JCCopyrights/Arriquitaun2.0/README.md

# Arriquitaun Project

Project to create a retroconsole using hardware coprocessors.

Thanks to @aquimb and specially Yago Torroja.
