JCCopyrights/Arriquitaun2.0/res/flamenco-dancer-clapping-silhouette-by-vexels.bmp

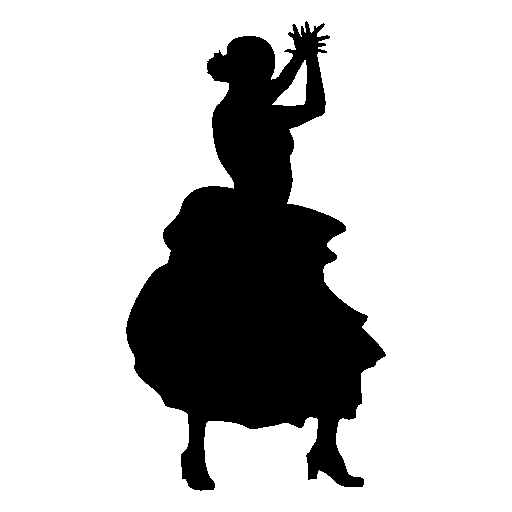
res/flamenco-dancer-clapping-silhouette-by-vexels.bmp
