JCCopyrights/Arriquitaun2.0/docs/BOM.xlsx

Part | Manufacturer Code | Needed x 1 | Neded x 3 | To Order | price 1 | price 5 | price 10 | price 25 | price 50 | price 100 | Llegado | Order [€] | Distributor | Code | link
micro | ATMEGA644PA-AU | 1 | 3 | 4 | 4.38 |  | 43.1 |  |  |  | 4 | 17.52 | Mouser | 556-ATMEGA644PA-AU | https://eu.mouser.com/ProductDetail/Microchip-Technology-Atmel/ATMEGA644PA-AU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
usb | 47346-0001 | 1 | 3 | 4 | 0.78 |  | 7.03 |  |  |  | 4 | 3.12 | Mouser | 538-47346-0001 | https://eu.mouser.com/ProductDetail/Molex/47346-0001
led | 598-8210-107F | 9 | 27 | 30 | 0.4 |  | 2.25 |  |  |  | 30 | 6.75 | Mouser | 645-598-8210-107F | https://eu.mouser.com/ProductDetail/Dialight/598-8210-107F
flash 4Mb | AT25SF041-SSHD-T | 1 | 3 | 4 | 0.31 |  | 2.6 |  |  |  | 4 | 1.24 | Mouser | 988-AT25SF041-SSHD-T | https://eu.mouser.com/ProductDetail/Adesto-Technologies/AT25SF041-SSHD-T
tactil switch | EVQ-Q2D01W | 1 | 3 | 4 | 0.26 |  | 2.4 |  |  |  | 4 | 1.04 | Mouser | 667-EVQ-Q2D01W | https://eu.mouser.com/ProductDetail/Panasonic/EVQ-Q2D01W
boton | FSM100 | 6 | 18 | 20 | 0.27 |  | 2.35 |  |  |  | 20 | 4.7 | Mouser | 506-FSM100 | https://eu.mouser.com/ProductDetail/TE-Connectivity-Alcoswitch/FSM100
ftdi | FT2232HL-TRAY | 1 | 3 | 4 | 5.86 |  | 54.1 |  |  |  | 4 | 23.44 | Mouser | 895-FT2232HL-TRAY | https://eu.mouser.com/ProductDetail/FTDI/FT2232HL-TRAY
SRAM 2Mb | IS62WVS2568FBLL-20NLI | 1 | 3 | 4 | 2.66 |  | 23.5 |  |  |  | 4 | 10.64 | Mouser | 870-WVS2568FBLL20NLI | https://eu.mouser.com/ProductDetail/ISSI/IS62WVS2568FBLL-20NLI
VGA connector | L77HDE15SD1CH4R | 1 | 3 | 4 | 1.14 |  | 10.4 |  |  |  | 4 | 4.56 | Mouser | 523-L77HDE15SD1CH4R | https://www.mouser.es/ProductDetail/Amphenol-Commercial-Products/L77HDE15SD1CH4R
fpga | ICE40UP5K-SG48I | 1 | 3 | 4 | 5.24 |  |  | 114.5 |  |  | 4 | 20.96 | Mouser | 842-ICE40UP5K-SG48I | https://eu.mouser.com/ProductDetail/Lattice/ICE40UP5K-SG48I
regu 3,3 | LD1117S33CTR | 1 | 3 | 4 | 0.35 |  | 2.95 |  |  |  | 4 | 1.4 | Mouser | 511-LD1117S33C | https://eu.mouser.com/ProductDetail/STMicroelectronics/LD1117S33CTR
eeprom 1Kb | M93C46-WMN6P | 1 | 3 | 4 | 0.14 |  | 1.21 |  |  |  | 4 | 0.56 | Mouser | 511-M93C46-WMN6P | https://eu.mouser.com/ProductDetail/STMicroelectronics/M93C46-WMN6P
regu 1.2 | TLV117112DCYR | 1 | 3 | 4 | 0.58 |  | 4.8 |  |  |  | 4 | 2.32 | Mouser | 595-TLV117112DCYR | https://eu.mouser.com/ProductDetail/Texas-Instruments/TLV117112DCYR
pal | 161-0097-E | 2 | 6 | 10 | 0.71 |  | 5.48 |  |  |  | 10 | 5.48 | Mouser | 161-0097-E | https://eu.mouser.com/ProductDetail/Kobiconn/161-0097-E?qs=%2Fha2pyFaduiSBnDJ69ivb8CZFsEH3V1cTsvfFz0YGCc=
reloj 16 | 7C-16.000MBB-T | 1 | 3 | 4 | 1.86 |  | 17.8 |  |  |  | 4 | 7.44 | Mouser | 717-7C-16.000MBB-T | https://eu.mouser.com/ProductDetail/TXC-Corporation/7C-16000MBB-T
cristal 12 Mhz | NX3225SA-12MHZ-STD-CSR-3 | 1 | 3 | 4 | 0.62 |  | 5.13 |  |  |  | 4 | 2.48 | Mouser | 344-NX3225SA12MCSR3 | https://eu.mouser.com/ProductDetail/NDK/NX3225SA-12MHZ-STD-CSR-3
mosfets | BSS138P,215 | 2 | 6 | 10 | 0.21 |  | 1.41 |  |  |  | 10 | 1.41 | Mouser | 771-BSS138P215 | https://eu.mouser.com/ProductDetail/Nexperia/BSS138P215
r 10 k 5% | CR1206-JW-103ELF | 25 | 75 | 100 | 0.09 |  | 0.14 |  |  | 0.8 | 100 | 0.8 | Mouser | 652-CR1206JW-103ELF | https://www.mouser.es/ProductDetail/Bourns/CR1206-JW-103ELF
r 1 k 5% | CR1206-JW-102ELF | 10 | 30 | 100 | 0.09 |  | 0.14 |  |  | 0.8 | 100 | 0.8 | Mouser | 652-CR1206-JW-102ELF | https://www.mouser.es/ProductDetail/Bourns/CR1206-JW-102ELF?qs=sGAEpiMZZMtlubZbdhIBIFLHRuY0Wf8zbyI2xCvKwW0%3D
r 12 k 1% | CR1206-FX-1202ELF | 1 | 3 | 10 | 0.09 |  | 0.17 |  |  |  | 10 | 0.17 | Mouser | 652-CR1206FX-1202ELF | https://www.mouser.es/ProductDetail/Bourns/CR1206-FX-1202ELF
r 510 1% | CR1206-FX-5100ELF | 4 | 12 | 20 | 0.11 |  | 0.2 |  |  | 1.1 | 20 | 0.4 | Mouser | 652-CR1206FX-5100ELF | https://www.mouser.es/ProductDetail/Bourns/CR1206-FX-5100ELF?qs=sGAEpiMZZMtlubZbdhIBIKcL8oyIJJKeNi6qwlkbLpY%3D
c 100 n | C1206C104M5RAC | 27 | 81 | 100 | 0.1 |  | 0.41 |  |  | 2.9 | ¡! | 2.9 | Mouser | 80-C1206C104M5RAC | https://www.mouser.es/ProductDetail/KEMET/C1206C104M5RAC
c 10 u | LMK316BJ106KL-T | 5 | 15 | 20 | 0.22 |  | 1 |  |  | 6.7 | 20 | 2 | Mouser | 963-LMK316BJ106KL-T | https://www.mouser.es/ProductDetail/Taiyo-Yuden/LMK316BJ106KL-T
pines fila de 6 | TSW-101-07-TM-S | 4 | 12 | 15 | 0.38 |  | 2.96 |  |  | 3.8 | ¡! | 4.44 | Mouser | 200-TSW10607TMS | https://www.mouser.es/ProductDetail/Samtec/TSW-106-07-TM-S?qs=sGAEpiMZZMvlX3nhDDO4AC5yIY7PTkfx4Fy2hijE3kI%3D
 |  |  |  |  |  |  |  |  |  |  |  | 126.57
