JCCopyrights/Arriquitaun2.0/docs/Arriquitaun.pdf

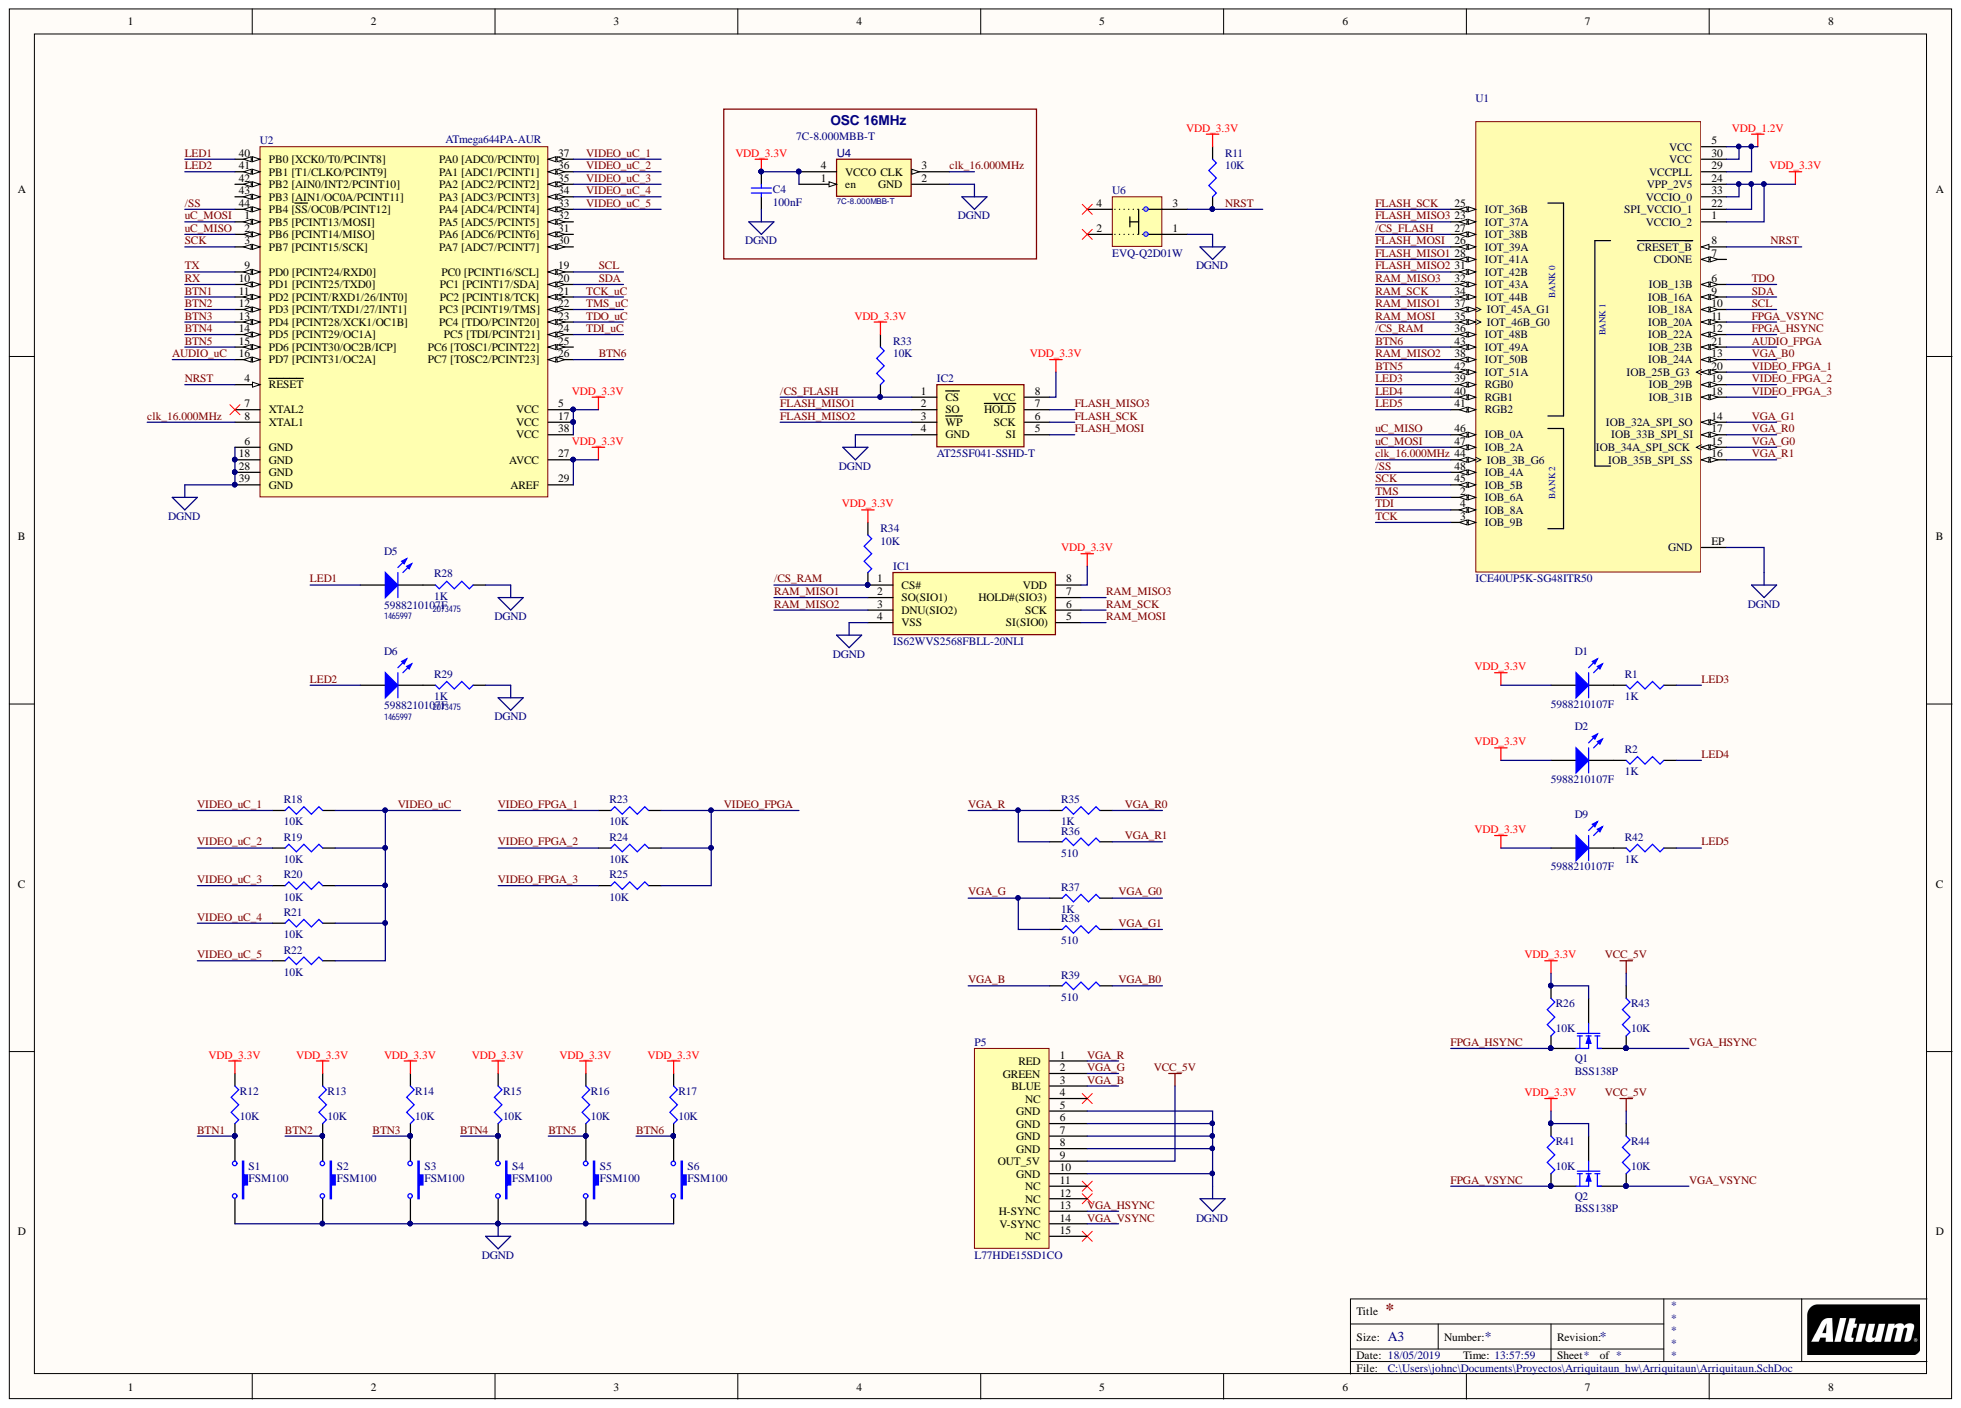
[picture p2: page 1]

* Title | * * * * *

Size: A3 | Number: * | Revision: *
Date: 18/05/2019 Time: 13:57:59 | | Sheet * of *

C:\Users\johnc\Documents\Proyectos\Arriquitaun_hw\Arriquitaun\Arriquitaun.SchDoc

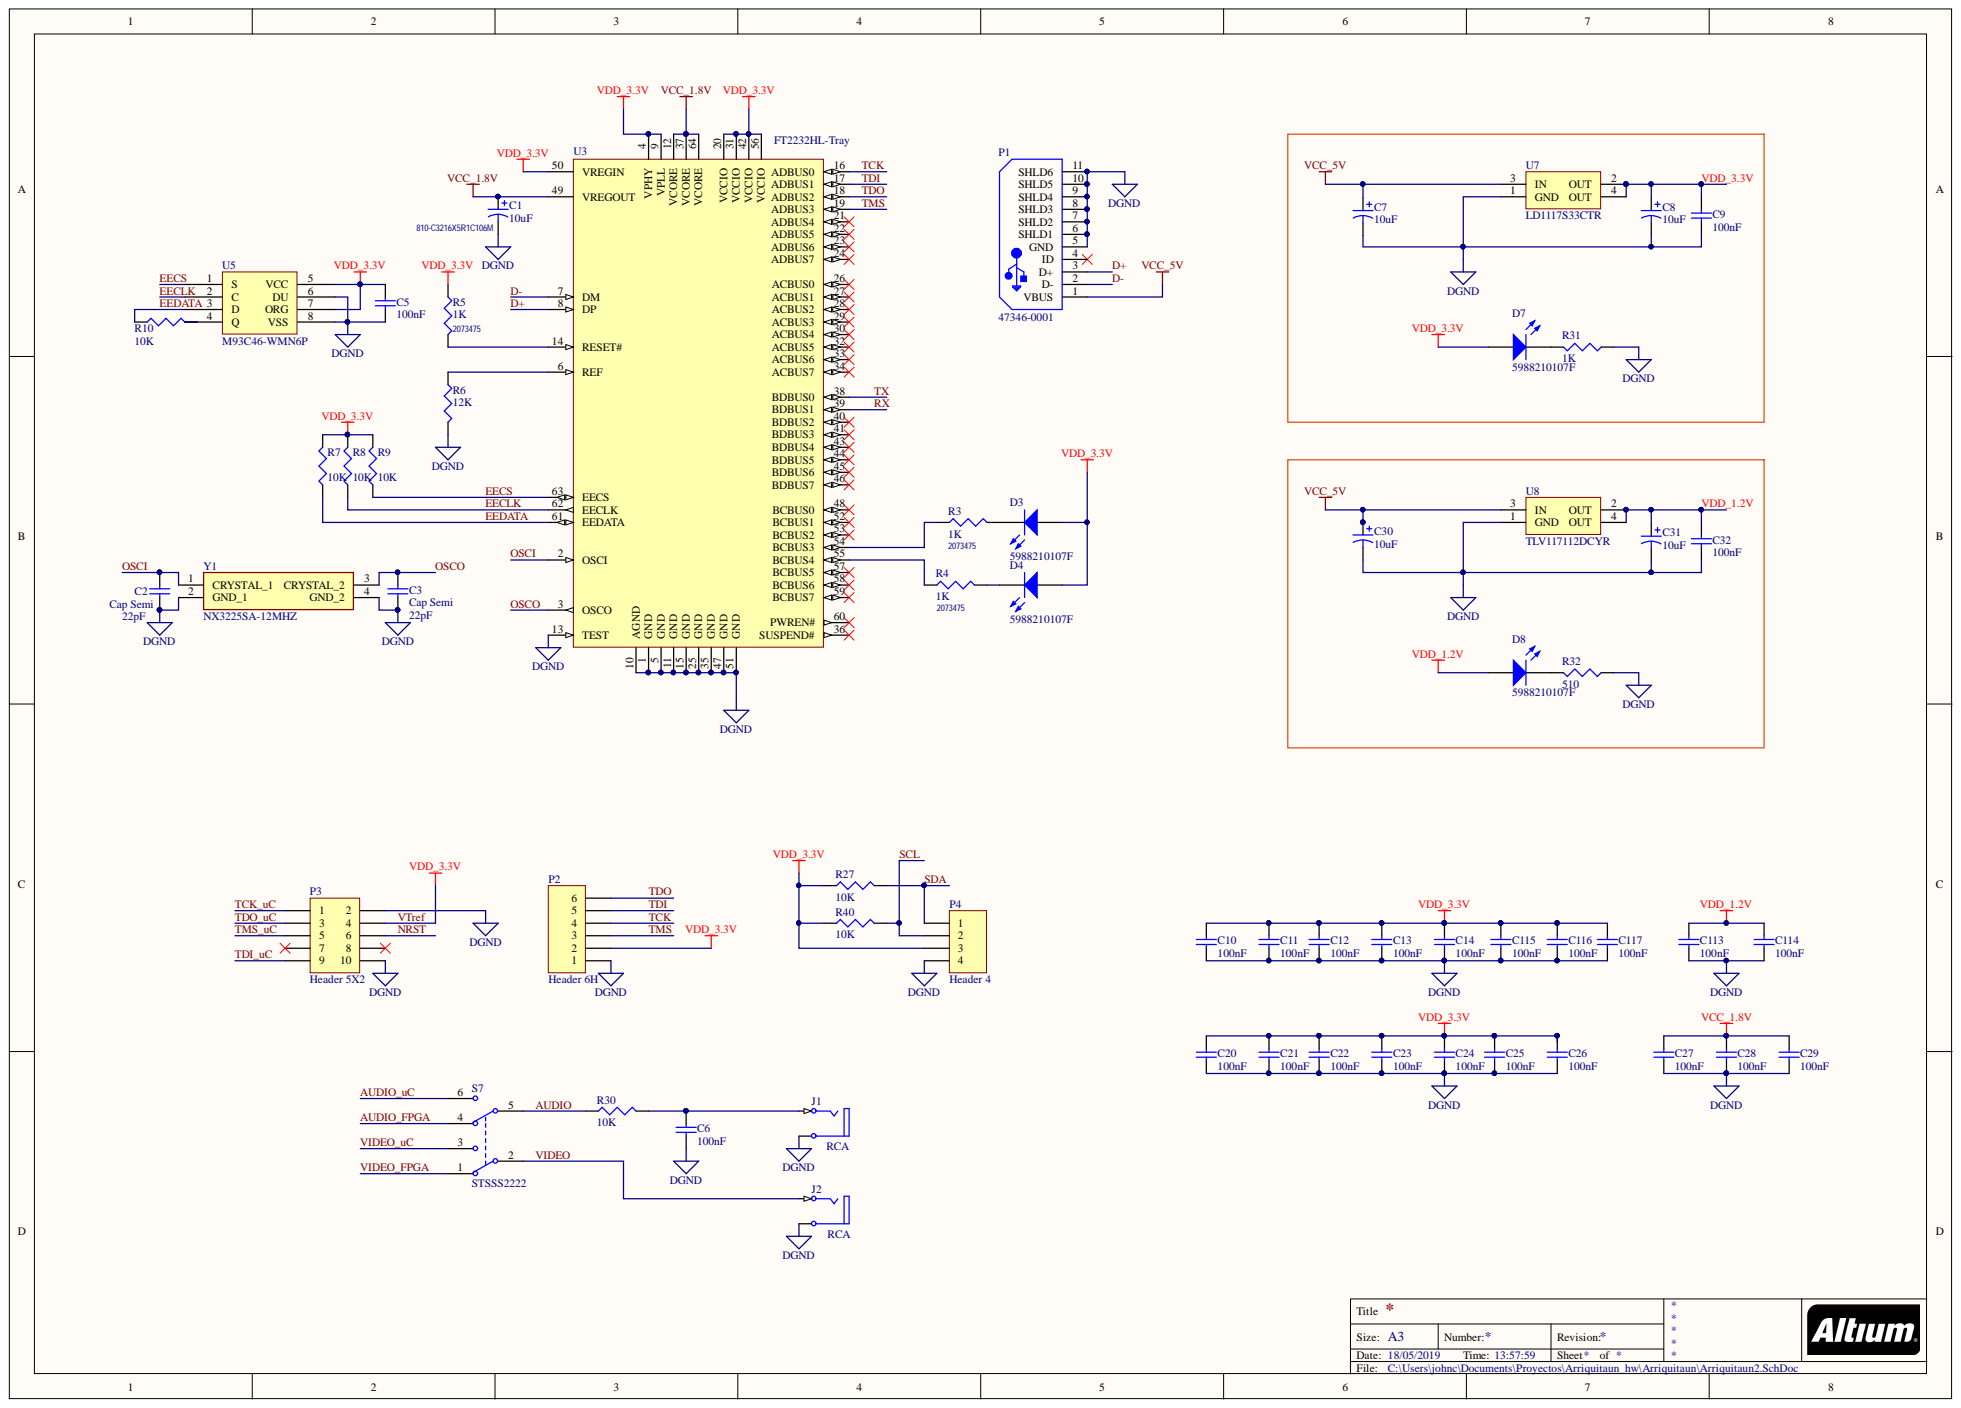
[picture p3: page 2]

* Title | * * * * *

Size: A3 | Number: * | Revision: *
Date: 18/05/2019 Time: 13:57:59 | | Sheet * of *

C:\Users\johnc\Documents\Proyectos\Arriquitaun_hw\Arriquitaun\Arriquitaun2.SchDoc

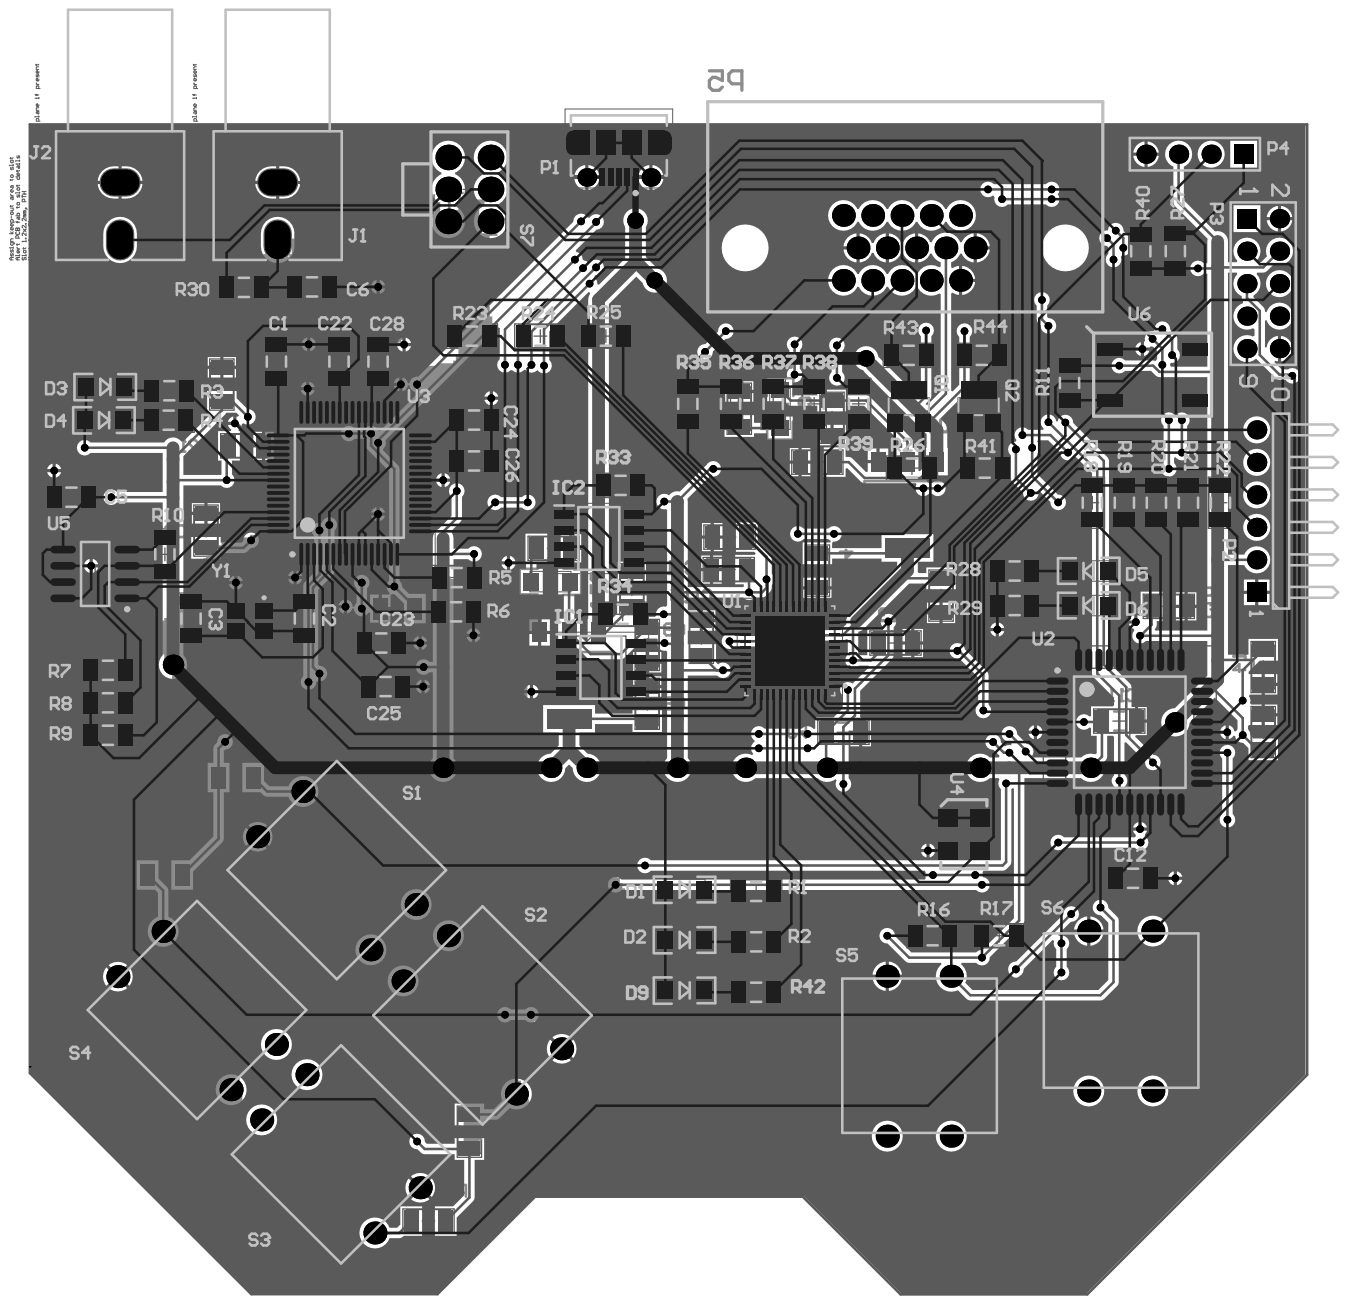
[picture p4: page 3]
