JCCopyrights/Arriquitaun2.0/(list of files, drawings)

Other design files:
Arriquitaun/Arriquitaun2.SchDoc
Arriquitaun/Arriquitaun.PcbLib
Arriquitaun/Arriquitaun.PrjPcb
Arriquitaun/Arriquitaun.SchDoc
Arriquitaun/Arriquitaun.SchLib
Arriquitaun/PCB_AIO.PcbDoc
