JCCopyrights/Arriquitaun2.0/(commit log)

2019-03-21 First commit with Arriquitaun v1.0
    [Arriquitaun.PcbLib, Arriquitaun.PrjPcb, Arriquitaun.SchDoc, Arriquitaun.SchLib, Arriquitaun.xls, BOM_ASD.xls, PCB1.PcbDoc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]
2019-04-08 Unified libraries, cleaned the project
    [Arriquitaun.PcbLib, Arriquitaun.PrjPcb, Arriquitaun.SchLib, PCB1.PcbDoc, PcbLib1.PcbLib]
2019-04-08 Added datasheets, cleaned up project
    [Arriquitaun.PrjPcb, Arriquitaun.SchDoc, Arriquitaun.SchLib, Arriquitaun.xls, BOM_ASD.xls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]
2019-04-08 Added power,memory,crystal.. @TODO:Make butifil & merge FPGA
    [Arriquitaun.PrjPcb, Arriquitaun.SchDoc, Arriquitaun.SchLib, Arriquitaun2.SchDoc, PCB_AIO.PcbDoc]
2019-04-09 Finished main components, cleaned libraries
    [Arriquitaun.PcbLib, Arriquitaun.PrjPcb, Arriquitaun.SchDoc, Arriquitaun.SchLib, Arriquitaun2.SchDoc, PCB_AIO.PcbDoc]
2019-04-09 Major Overhaul of compatibility and lbraries
    [Arriquitaun.PcbLib, Arriquitaun.PrjPcb, Arriquitaun.SchDoc, Arriquitaun.SchLib, Arriquitaun2.SchDoc, PCB_AIO.PcbDoc]
2019-04-09 Added VGA and shit
    [Arriquitaun.PcbLib, Arriquitaun.SchDoc, Arriquitaun.SchLib]
2019-04-09 Added distributors to components.Added inteligent BOM
    [Arriquitaun.PrjPcb, Arriquitaun.SchDoc, Arriquitaun.SchLib, Arriquitaun.xls, Arriquitaun2.SchDoc]
2019-04-10 sch terminado
    [Arriquitaun.SchDoc, Arriquitaun.SchLib]
2019-04-10 Final schematic previous to revision
    [Arriquitaun.PcbLib, Arriquitaun.PrjPcb, Arriquitaun.SchDoc, Arriquitaun.SchLib, Arriquitaun2.SchDoc, PCB_AIO.PcbDoc]
2019-04-11 sch definitivo
    [Arriquitaun.SchDoc, Arriquitaun2.SchDoc]
2019-04-11 bom final
    [lista componentes.xlsx]
2019-04-13 Updated BOM. Fixed errors in schematic. Compiled PCB
    [Arriquitaun.PrjPcb, Arriquitaun.SchDoc, Arriquitaun2.SchDoc, BOM.xlsx, lista componentes.xlsx]
2019-04-16 layout FPGA y uC
    [Arriquitaun.PcbLib, Arriquitaun.SchDoc, Arriquitaun.SchLib, Arriquitaun2.SchDoc, PCB_AIO.PcbDoc]
2019-04-19 rutado a falta de planos
    [Arriquitaun2.SchDoc, PCB_AIO.PcbDoc]
2019-04-23 Updated Layout
    [Arriquitaun.PcbLib, Arriquitaun.PrjPcb, Arriquitaun.xls, BOM.xlsx, PCB_AIO.PcbDoc]
2019-04-26 Rerouted the PCB.Generated Gerber Files.
    [Arriquitaun.PrjPcb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]
2019-05-18 Added ERRATA for v2.0, added real values to FTDI oscilator
    [Arriquitaun.SchDoc, Arriquitaun2.SchDoc, BOM.xlsx, PCB_AIO.PcbDoc]
2019-07-31 Updated Schematics with Memory Configuration
    [Arriquitaun.PcbLib, Arriquitaun.PrjPcb, Arriquitaun.SchDoc, Arriquitaun2.SchDoc, PCB_AIO.PcbDoc]
